AlexandrePTJ/PedalComposer/kicad/main_board/JLC_BOM.xlsx

Comment | Designator | Footprint | Part
10nF | C3 | Capacitor_SMD:C_0603_1608Metric | C100042
1uF | C2, C4 | Capacitor_SMD:CP_Elec_4x5.4 | C72491
12pF | C5, C6 | Capacitor_SMD:C_0603_1608Metric | C38523
100nF | C1, C7, C9, C10, C11, C12 | Capacitor_SMD:C_0603_1608Metric | C14663
2.2uF | C8, C13 | Capacitor_SMD:C_0805_2012Metric | C19110
LED | D5, D6 | LED_SMD:LED_0603_1608Metric | C2297
AVR-ISP-6 | J10 | Connector_PinHeader_2.54mm:PinHeader_2x03_P2.54mm_Vertical | C65114
 | J11 | Connector_PinHeader_2.54mm:PinHeader_1x10_P2.54mm_Vertical | C57369
330 | R1 | Resistor_SMD:R_0603_1608Metric | C23138
1k | R2 | Resistor_SMD:R_0603_1608Metric | C21190
1M | R5, R6, R7, R8, R9, R10, R11, R12, R13, R14, R16, R17, R18, R19, R20, R21, R22, R26, R30 | Resistor_SMD:R_0603_1608Metric | C22935
470 | R3, R4, R23, R24, R25, R27, R28, R29, R32, R33, R34, R35, R36, R37, R38, R39 | Resistor_SMD:R_0603_1608Metric | C23179
10k | R15, R31 | Resistor_SMD:R_0603_1608Metric | C25804
 | SW11 | Button_Switch_THT:SW_PUSH_6mm | C13828
 | U3 | Package_SO:SOIC-16_3.9x9.9mm_P1.27mm | C28326
 | U5 | Package_DIP:DIP-40_W15.24mm_Socket | C2332
 | U10, U20, U30 | Package_DIP:DIP-16_W7.62mm_Socket | C2326
16MHz | Y1 | Crystal:Crystal_SMD_3225-4Pin_3.2x2.5mm | C13738
SM4002 | D7, D8 | Diode_SMD:D_SOD-123F | C151753
