AlexandrePTJ/PedalComposer/kicad/ctrl_board/ctrl_board.kicad_pcb

## KiCad design kicad/ctrl_board/ctrl_board.kicad_pcb (2022-12-11)

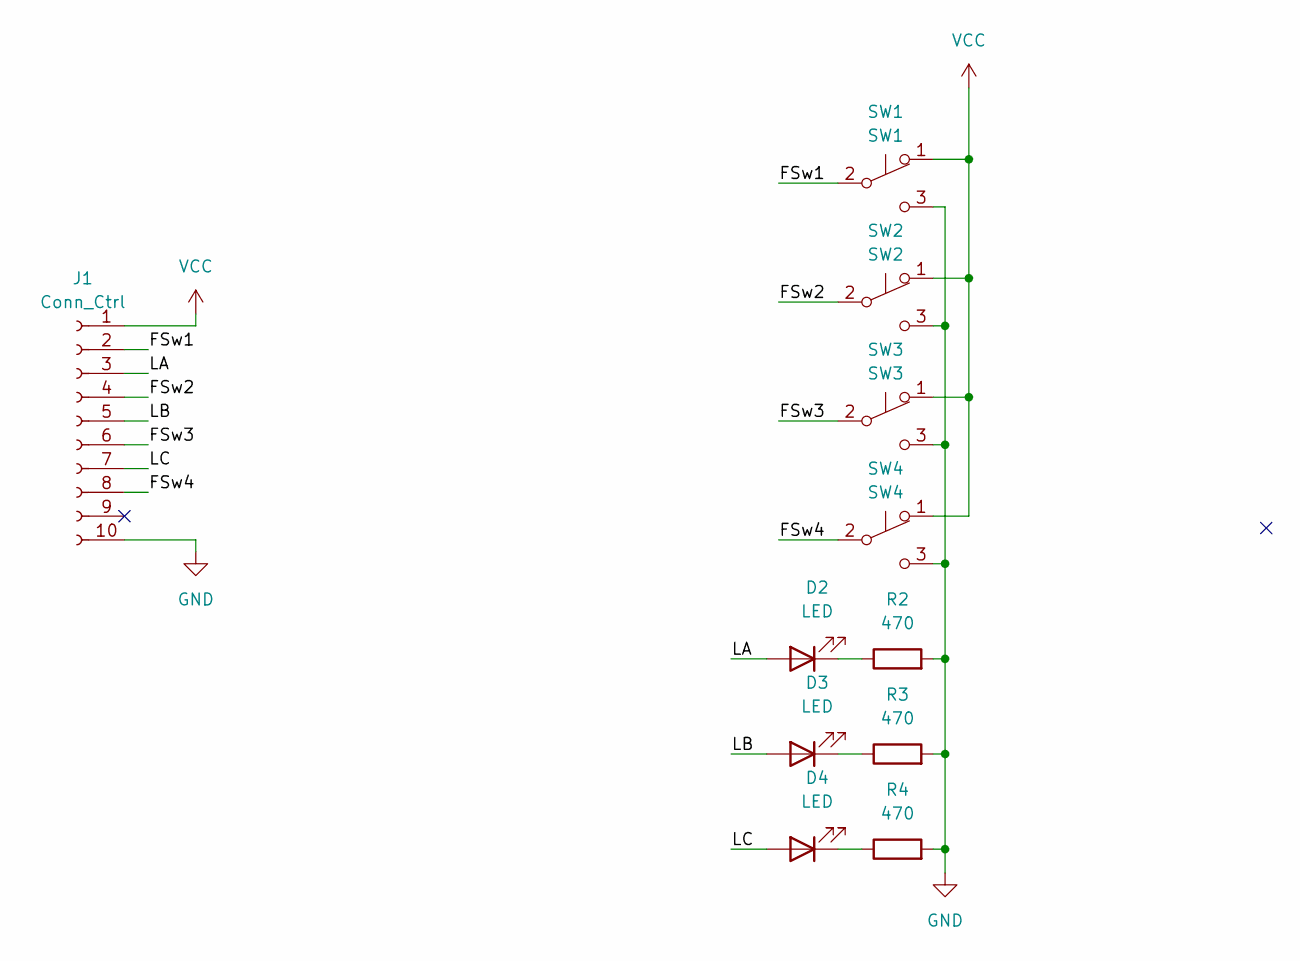
[picture p1: schematic ctrl_board.kicad_sch]

Parts:
D2, D3, D4: LED; LED_D3.0mm
J1: Conn_Ctrl; PinHeader_1x10_P2.54mm_Vertical
R2, R3, R4: 470; R_Axial_DIN0207_L6.3mm_D2.5mm_P7.62mm_Horizontal
SW1: SW1; SPDT Momentum
SW2: SW2; SPDT Momentum
SW3: SW3; SPDT Momentum
SW4: SW4; SPDT Momentum

Connections:
/FSw1: J1.2, SW1.2 (B)
/FSw2: J1.4, SW2.2 (B)
/FSw3: J1.6, SW3.2 (B)
/FSw4: J1.8, SW4.2 (B)
/LA: D2.2 (A), J1.3
/LB: D3.2 (A), J1.5
/LC: D4.2 (A), J1.7
GND: J1.10, R2.2, R3.2, R4.2, SW1.3 (C), SW2.3 (C), SW3.3 (C), SW4.3 (C)
unnamed: D2.1 (K), R2.1
unnamed: D3.1 (K), R3.1
unnamed: D4.1 (K), R4.1
VCC: J1.1, SW1.1 (A), SW2.1 (A), SW3.1 (A), SW4.1 (A)

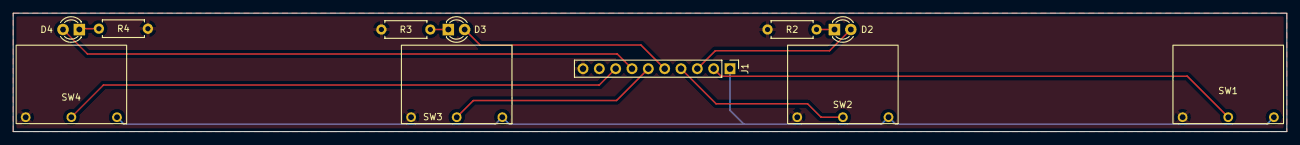
[picture p2: board ctrl_board.kicad_pcb from above]

Board: 2 copper layers, 198.1 x 18.4 mm, 11 parts (0 on the bottom side), 12 nets.
