AlexandrePTJ/PedalComposer/kicad/main_board/PedalComposer.kicad_pcb

## KiCad design kicad/main_board/PedalComposer.kicad_pcb (2022-12-11)

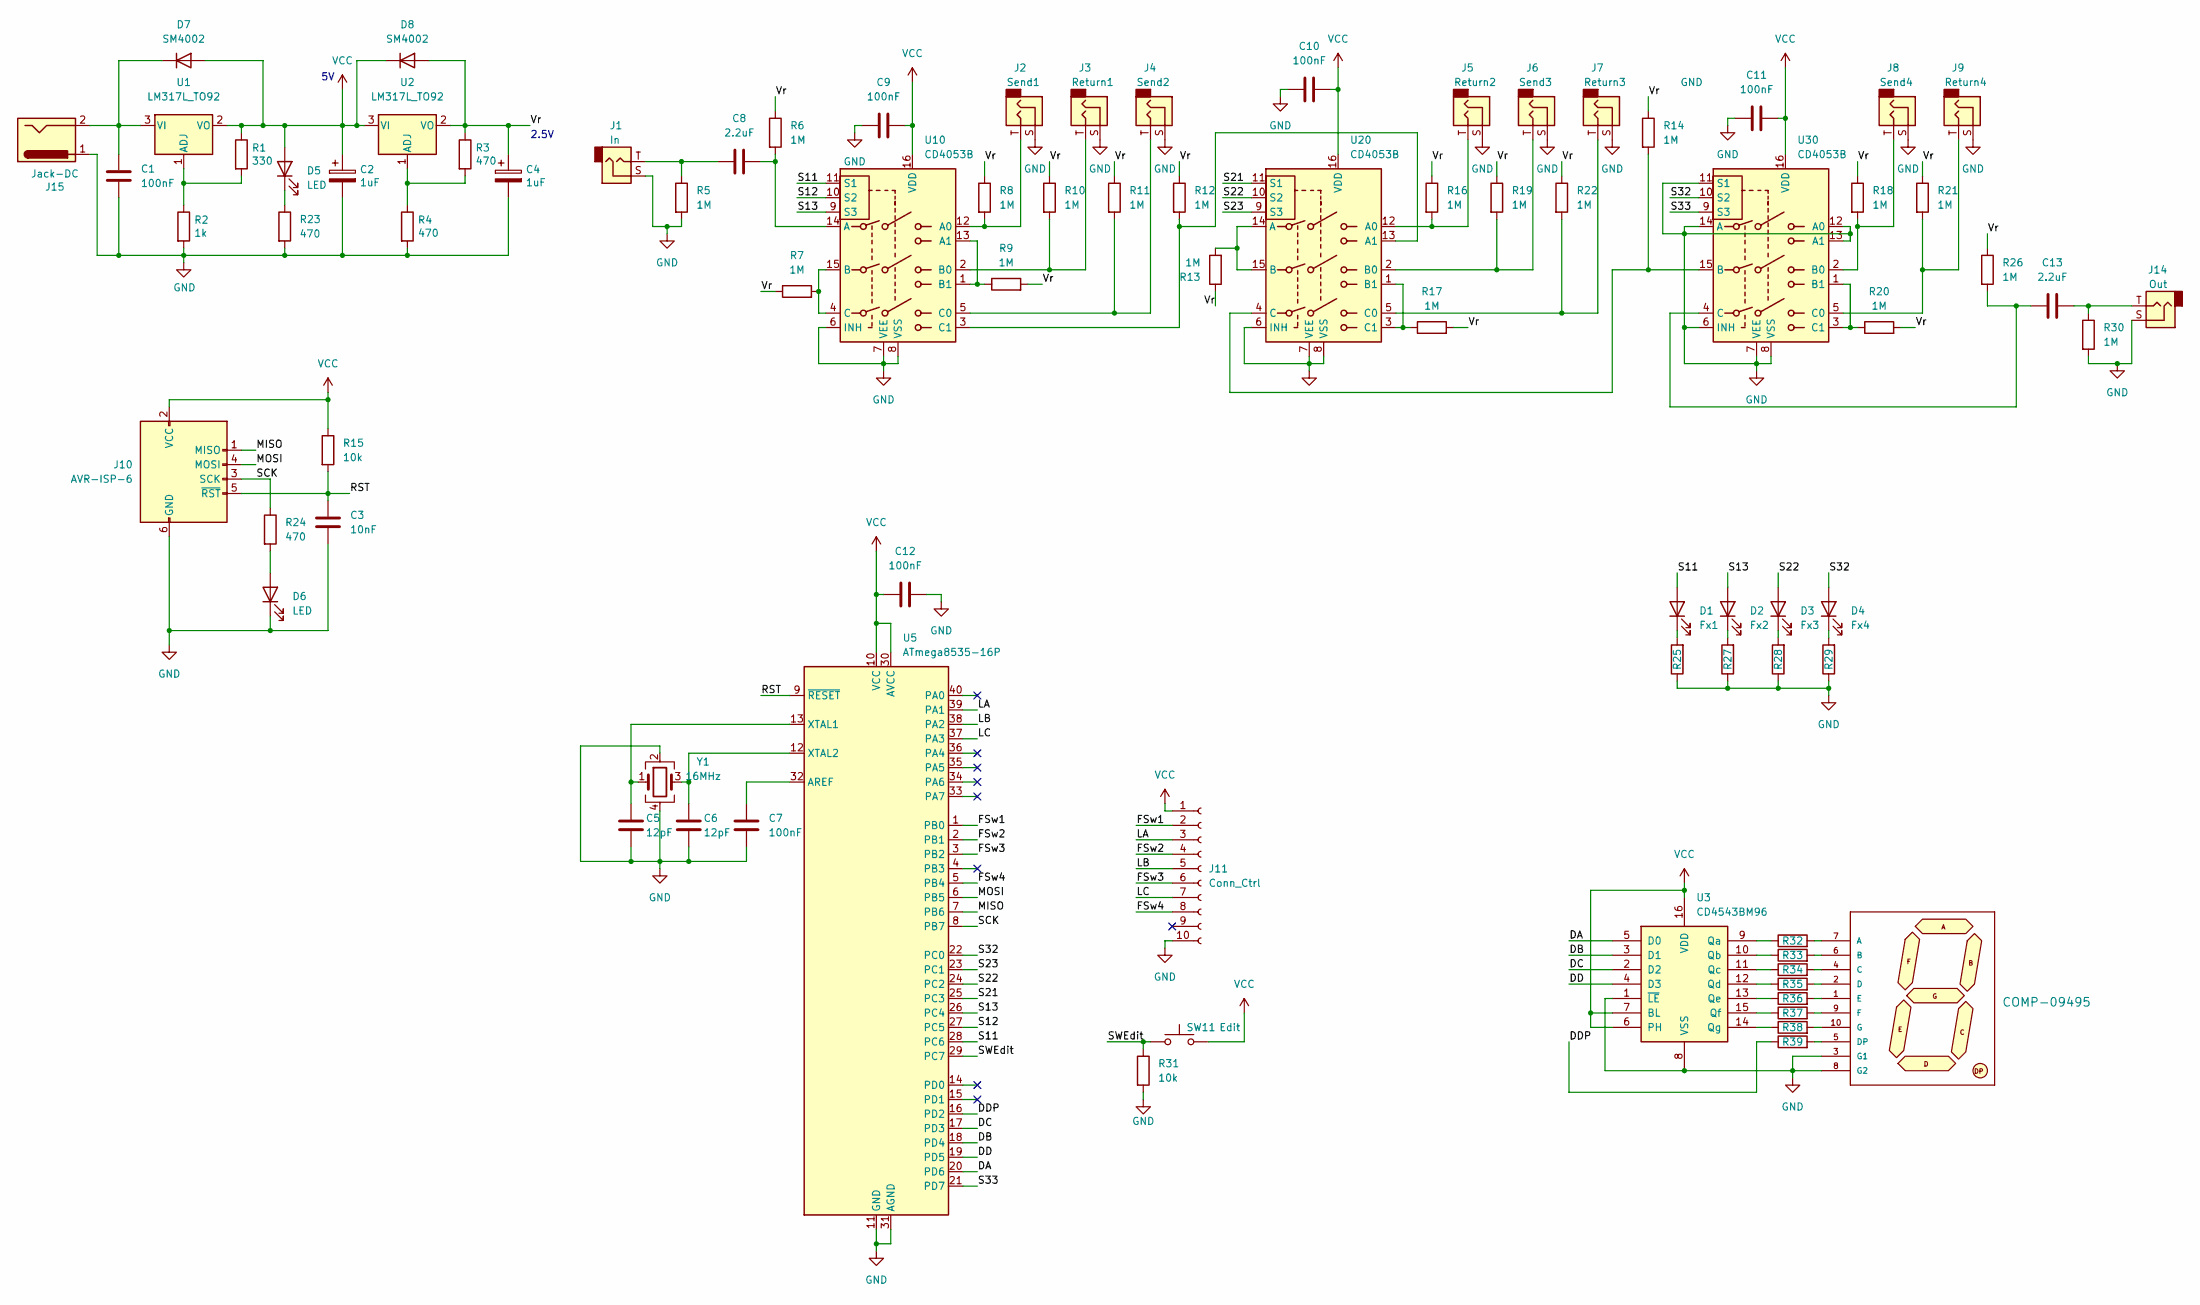
[picture p3: schematic PedalComposer.kicad_sch, Pedal Fx Composer]

Parts:
C1, C7, C9, C10, C11, C12: 100nF; C_0603_1608Metric; LCSC C14663
C2, C4: 1uF; CP_Elec_4x5.4; LCSC C72491
C3: 10nF; C_0603_1608Metric; LCSC C100042
C5, C6: 12pF; C_0603_1608Metric; LCSC C38523
C8, C13: 2.2uF; C_0805_2012Metric; LCSC C19110
D1: Fx1; LED_D3.0mm
D2: Fx2; LED_D3.0mm
D3: Fx3; LED_D3.0mm
D4: Fx4; LED_D3.0mm
D5, D6: LED; LED_0603_1608Metric; LCSC C2297
D7, D8: SM4002; D_SOD-123F; LCSC C151753
J1: In; Jack_6.35mm_Neutrik_NRJ4HF_Horizontal
J2: Send1; Jack_6.35mm_Neutrik_NRJ4HF_Horizontal
J3: Return1; Jack_6.35mm_Neutrik_NRJ4HF_Horizontal
J4: Send2; Jack_6.35mm_Neutrik_NRJ4HF_Horizontal
J5: Return2; Jack_6.35mm_Neutrik_NRJ4HF_Horizontal
J6: Send3; Jack_6.35mm_Neutrik_NRJ4HF_Horizontal
J7: Return3; Jack_6.35mm_Neutrik_NRJ4HF_Horizontal
J8: Send4; Jack_6.35mm_Neutrik_NRJ4HF_Horizontal
J9: Return4; Jack_6.35mm_Neutrik_NRJ4HF_Horizontal
J10: AVR-ISP-6; PinHeader_2x03_P2.54mm_Vertical; LCSC C65114
J11: Conn_Ctrl; PinHeader_1x10_P2.54mm_Vertical; LCSC C57369
J14: Out; Jack_6.35mm_Neutrik_NRJ4HF_Horizontal
J15: Jack-DC; BarrelJack_Horizontal
M1: 7-SEGMENT-1DIGIT-1INCH-BLUE; 7SegmentLED_LTS6760_LTS6780
R1: 330; R_0603_1608Metric; LCSC C23138
R2: 1k; R_0603_1608Metric; LCSC C21190
R3, R4, R23, R24, R25, R27, R28, R29, R32, R33, R34, R35, R36, R37, R38, R39: 470; R_0603_1608Metric; LCSC C23179
R5, R6, R7, R8, R9, R10, R11, R12, R13, R14, R16, R17, R18, R19, R20, R21, R22, R26, R30: 1M; R_0603_1608Metric; LCSC C22935
R15, R31: 10k; R_0603_1608Metric; LCSC C25804
SW11: Edit; SW_PUSH_6mm; LCSC C13828
U1, U2: LM317L_TO92; TO-92_Inline
U3: CD4543BM96; SOIC-16_3.9x9.9mm_P1.27mm; LCSC C28326
U5: ATmega8535-16P; DIP-40_W15.24mm_Socket; LCSC C2332
U10, U20, U30: CD4053B; DIP-16_W7.62mm_Socket; LCSC C2326
Y1: 16MHz; Crystal_SMD_3225-4Pin_3.2x2.5mm; LCSC C13738

Connections:
/DA: U3.5 (D0), U5.20 (PD6)
/DB: U3.3 (D1), U5.18 (PD4)
/DC: U3.2 (D2), U5.17 (PD3)
/DD: U3.4 (D3), U5.19 (PD5)
/DDP: R39.1, U5.16 (PD2)
/FSw1: J11.2, U5.1 (PB0)
/FSw2: J11.4, U5.2 (PB1)
/FSw3: J11.6, U5.3 (PB2)
/FSw4: J11.8, U5.5 (PB4)
/LA: J11.3, U5.39 (PA1)
/LB: J11.5, U5.38 (PA2)
/LC: J11.7, U5.37 (PA3)
/MISO: J10.1 (MISO), U5.7 (PB6)
/MOSI: J10.4 (MOSI), U5.6 (PB5)
/RST: C3.2, J10.5 (~RST), R15.2, U5.9 (~RESET)
/S11: D1.2 (A), U5.28 (PC6), U10.11 (S1)
/S12: U5.27 (PC5), U10.10 (S2)
/S13: D2.2 (A), U5.26 (PC4), U10.9 (S3)
/S21: U5.25 (PC3), U20.11 (S1)
/S22: D3.2 (A), U5.24 (PC2), U20.10 (S2)
/S23: U5.23 (PC1), U20.9 (S3)
/S32: D4.2 (A), U5.22 (PC0), U30.10 (S2)
/S33: U5.21 (PD7), U30.9 (S3)
/SCK: J10.3 (SCK), R24.1, U5.8 (PB7)
/SWEdit: R31.1, SW11.1, U5.29 (PC7)
/Vr: C4.1, D8.2 (A), R3.1, R6.1, R7.1, R8.1, R9.2, R10.1, R11.1, R12.1, R13.1, R14.1, R16.1, R17.2, R18.1, R19.1, R20.2, R21.1, R22.1, R26.1, U2.2 (VO)
GND: C1.2, C2.2, C3.1, C4.2, C5.2, C6.2, C7.2, C9.1, C10.1, C11.1, C12.2, D6.1 (K), J1.S, J2.S, J3.S, J4.S, J5.S, J6.S, J7.S, J8.S, J9.S, J10.6 (GND), J11.10, J14.S, J15.1, M1.3 (G1), M1.8 (G2), R2.2, R4.2, R5.2, R23.2, R25.1, R27.1, R28.1, R29.1, R30.2, R31.2, U3.1 (~LE), U3.8 (VSS), U5.11 (GND), U5.31 (AGND), U10.6 (INH), U10.7 (VEE), U10.8 (VSS), U20.6 (INH), U20.7 (VEE), U20.8 (VSS), U30.6 (INH), U30.7 (VEE), U30.8 (VSS), U30.11 (S1), U30.12 (A0), U30.13 (A1), U30.14 (A), Y1.2, Y1.4
unnamed: C1.1, D7.1 (K), J15.2, U1.3 (VI)
unnamed: C5.1, U5.13 (XTAL1), Y1.1
unnamed: C6.1, U5.12 (XTAL2), Y1.3
unnamed: C7.1, U5.32 (AREF)
unnamed: C8.1, J1.T, R5.1
unnamed: C8.2, R6.2, U10.14 (A)
unnamed: C13.1, R26.2, U30.4 (C)
unnamed: C13.2, J14.T, R30.1
unnamed: D1.1 (K), R25.2
unnamed: D2.1 (K), R27.2
unnamed: D3.1 (K), R28.2
unnamed: D4.1 (K), R29.2
unnamed: D5.1 (K), R23.1
unnamed: D6.2 (A), R24.2
unnamed: J2.T, R8.2, U10.12 (A0)
unnamed: J3.T, R10.2, U10.2 (B0)
unnamed: J4.T, R11.2, U10.5 (C0)
unnamed: J5.T, R16.2, U20.12 (A0)
unnamed: J6.T, R19.2, U20.2 (B0)
unnamed: J7.T, R22.2, U20.5 (C0)
unnamed: J8.T, R18.2, U30.2 (B0)
unnamed: J9.T, R21.2, U30.5 (C0)
unnamed: M1.1 (E), R36.2
unnamed: M1.2 (D), R35.2
unnamed: M1.4 (C), R34.2
unnamed: M1.5 (DP), R39.2
unnamed: M1.6 (B), R33.2
unnamed: M1.7 (A), R32.2
unnamed: M1.9 (F), R37.2
unnamed: M1.10 (G), R38.2
unnamed: R1.2, R2.1, U1.1 (ADJ)
unnamed: R3.2, R4.1, U2.1 (ADJ)
unnamed: R7.2, U10.4 (C), U10.15 (B)
unnamed: R9.1, U10.1 (B1), U10.13 (A1)
unnamed: R12.2, U10.3 (C1), U20.13 (A1)
unnamed: R13.2, U20.14 (A), U20.15 (B)
unnamed: R14.2, U20.4 (C), U30.15 (B)
unnamed: R17.1, U20.1 (B1), U20.3 (C1)
unnamed: R20.1, U30.1 (B1), U30.3 (C1)
unnamed: R32.1, U3.9 (Qa)
unnamed: R33.1, U3.10 (Qb)
unnamed: R34.1, U3.11 (Qc)
unnamed: R35.1, U3.12 (Qd)
unnamed: R36.1, U3.13 (Qe)
unnamed: R37.1, U3.15 (Qf)
unnamed: R38.1, U3.14 (Qg)
VCC: C2.1, C9.2, C10.2, C11.2, C12.1, D5.2 (A), D7.2 (A), D8.1 (K), J10.2 (VCC), J11.1, R1.1, R15.1, SW11.2, U1.2 (VO), U2.3 (VI), U3.6 (PH), U3.7 (BL), U3.16 (VDD), U5.10 (VCC), U5.30 (AVCC), U10.16 (VDD), U20.16 (VDD), U30.16 (VDD)

Notes on the sheet:
2.5V

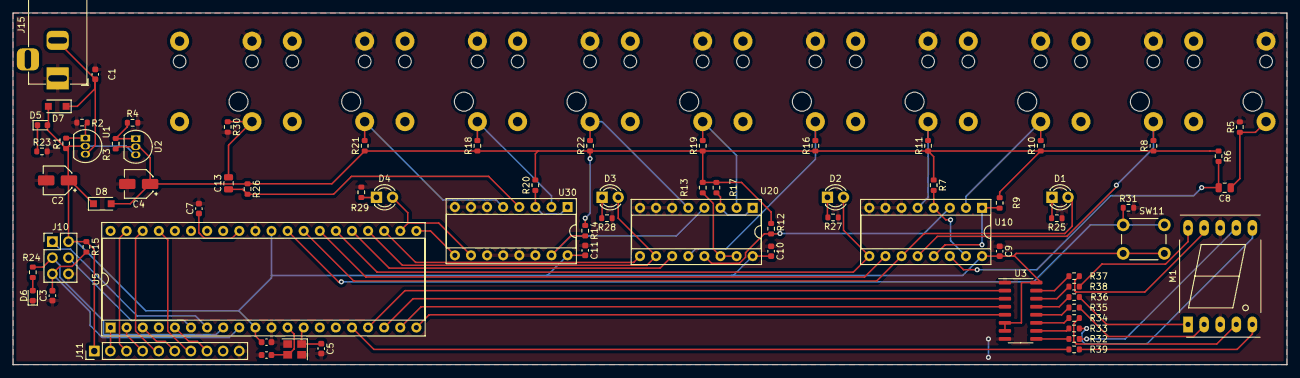
[picture p4: board PedalComposer.kicad_pcb from above]

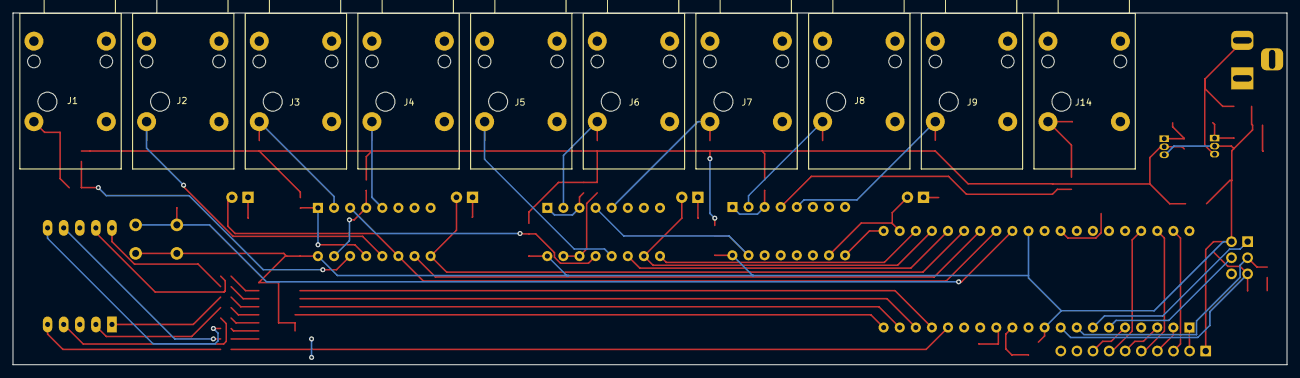
[picture p5: board PedalComposer.kicad_pcb from below]

Board: 2 copper layers, 201.0 x 55.5 mm, 83 parts (10 on the bottom side), 74 nets.
