AlexandrePTJ/PedalComposer/code/include/pedalcomposer_pins.h

#ifndef BDM_PEDAL_COMPOSER_PINS_H
#define BDM_PEDAL_COMPOSER_PINS_H

// Footswitchs LEDS
static const int PIN_LA = 39;
static const int PIN_LB = 38;
static const int PIN_LC = 37;

// Footswitchs
static const int PIN_FSW1 = 1;
static const int PIN_FSW2 = 2;
static const int PIN_FSW3 = 3;
static const int PIN_FSW4 = 5;

// Audio switches BCD
static const int PIN_S11 = 28;
static const int PIN_S12 = 27;
static const int PIN_S13 = 26;
static const int PIN_S21 = 25;
static const int PIN_S22 = 24;
static const int PIN_S23 = 23;
// static const int PIN_S31 = ; // NC
static const int PIN_S32 = 22;
static const int PIN_S33 = 21;

// 7-Segments drivers + dot
static const int PIN_DA = 20;
static const int PIN_DB = 18;
static const int PIN_DC = 17;
static const int PIN_DD = 19;
static const int PIN_DDP = 16;

#endif // BDM_PEDAL_COMPOSER_PINS_H
