AlexandrePTJ/PedalComposer/(commit log)

2022-11-01 Add schematics
    [PedalComposer.kicad_pcb, PedalComposer.kicad_sch]
2022-11-15 Update sch, down to 4 Fx
    [PedalComposer.kicad_pcb, PedalComposer.kicad_sch]
2022-11-16 WIP layout
    [PedalComposer.kicad_pcb, PedalComposer.kicad_sch]
2022-11-23 Update PCB
    [PedalComposer.kicad_pcb, PedalComposer.kicad_sch]
2022-12-11 Boards v1
    [JLC_BOM.xlsx, PedalComposer.kicad_pcb, PedalComposer.kicad_sch, ctrl_board.kicad_pcb, ctrl_board.kicad_sch]
